ekyerli/Signal_Generator/README.md

# Signal_Generator
We designed a signal generator within the scope of microelectronic systems course. The criteria required for us to be able to adjust the amplitude and frequency in the continuity of our project's ability to provide square, triangle, sine, impulse and ramp functions in loaded and unloaded conditions.
