ekyerli/Signal_Generator/Sonuçların karşılaştırılması.docx

Simülasyon
| Kare | Üçgen | Sinüs | Pulse | Rampa
1 | 100mV-9.8V | 20mV-1V | 1mV-400mV | 100mV-7V | 0.71V-3.5v
2 | 50Hz-2.5kHz | 50Hz-2.5kHz | 100Hz-2.5kHz | 100Hz-1.6kHz | 70Hz-3Khz
3 | -- | -- | -- | -- | --
4 | 50Hz-2.5kHz | 1kHz-7Khz | 1kHz-5Khz | 100Hz -3kHZ | Gözlenemedi
Deney Sonucu
| Kare | Üçgen | Sinüs | Pulse | Rampa
1 | 224mV-10.8V | 48.8mV-820mV | 60mV-380mV | 150mV-6V | 1.12V-2.24V
2 | 294Hz-3.91kHz | 303Hz-2.63kHz | 300Hz-1.87kHz | 149Hz-2.19kHz | 76.9Hz-2kHz
3 | -- | -- | -- | -- | --
4 | 79Hz-2.5kHz | 1.6kHz-9.35kHz | 1.8kHz-3.4kHz | 200Hz-1.9kHz | Gözlenemedi
