ekyerli/Signal_Generator/(list of files, drawings)

Other design files:
proje/final.pdsprj
rampa/rampa.pdsprj
